cculpepper/ILC2-12_CH32/pcb/VFDSAO.kicad_sch

## KiCad design pcb/VFDSAO.kicad_sch (2024-12-26)

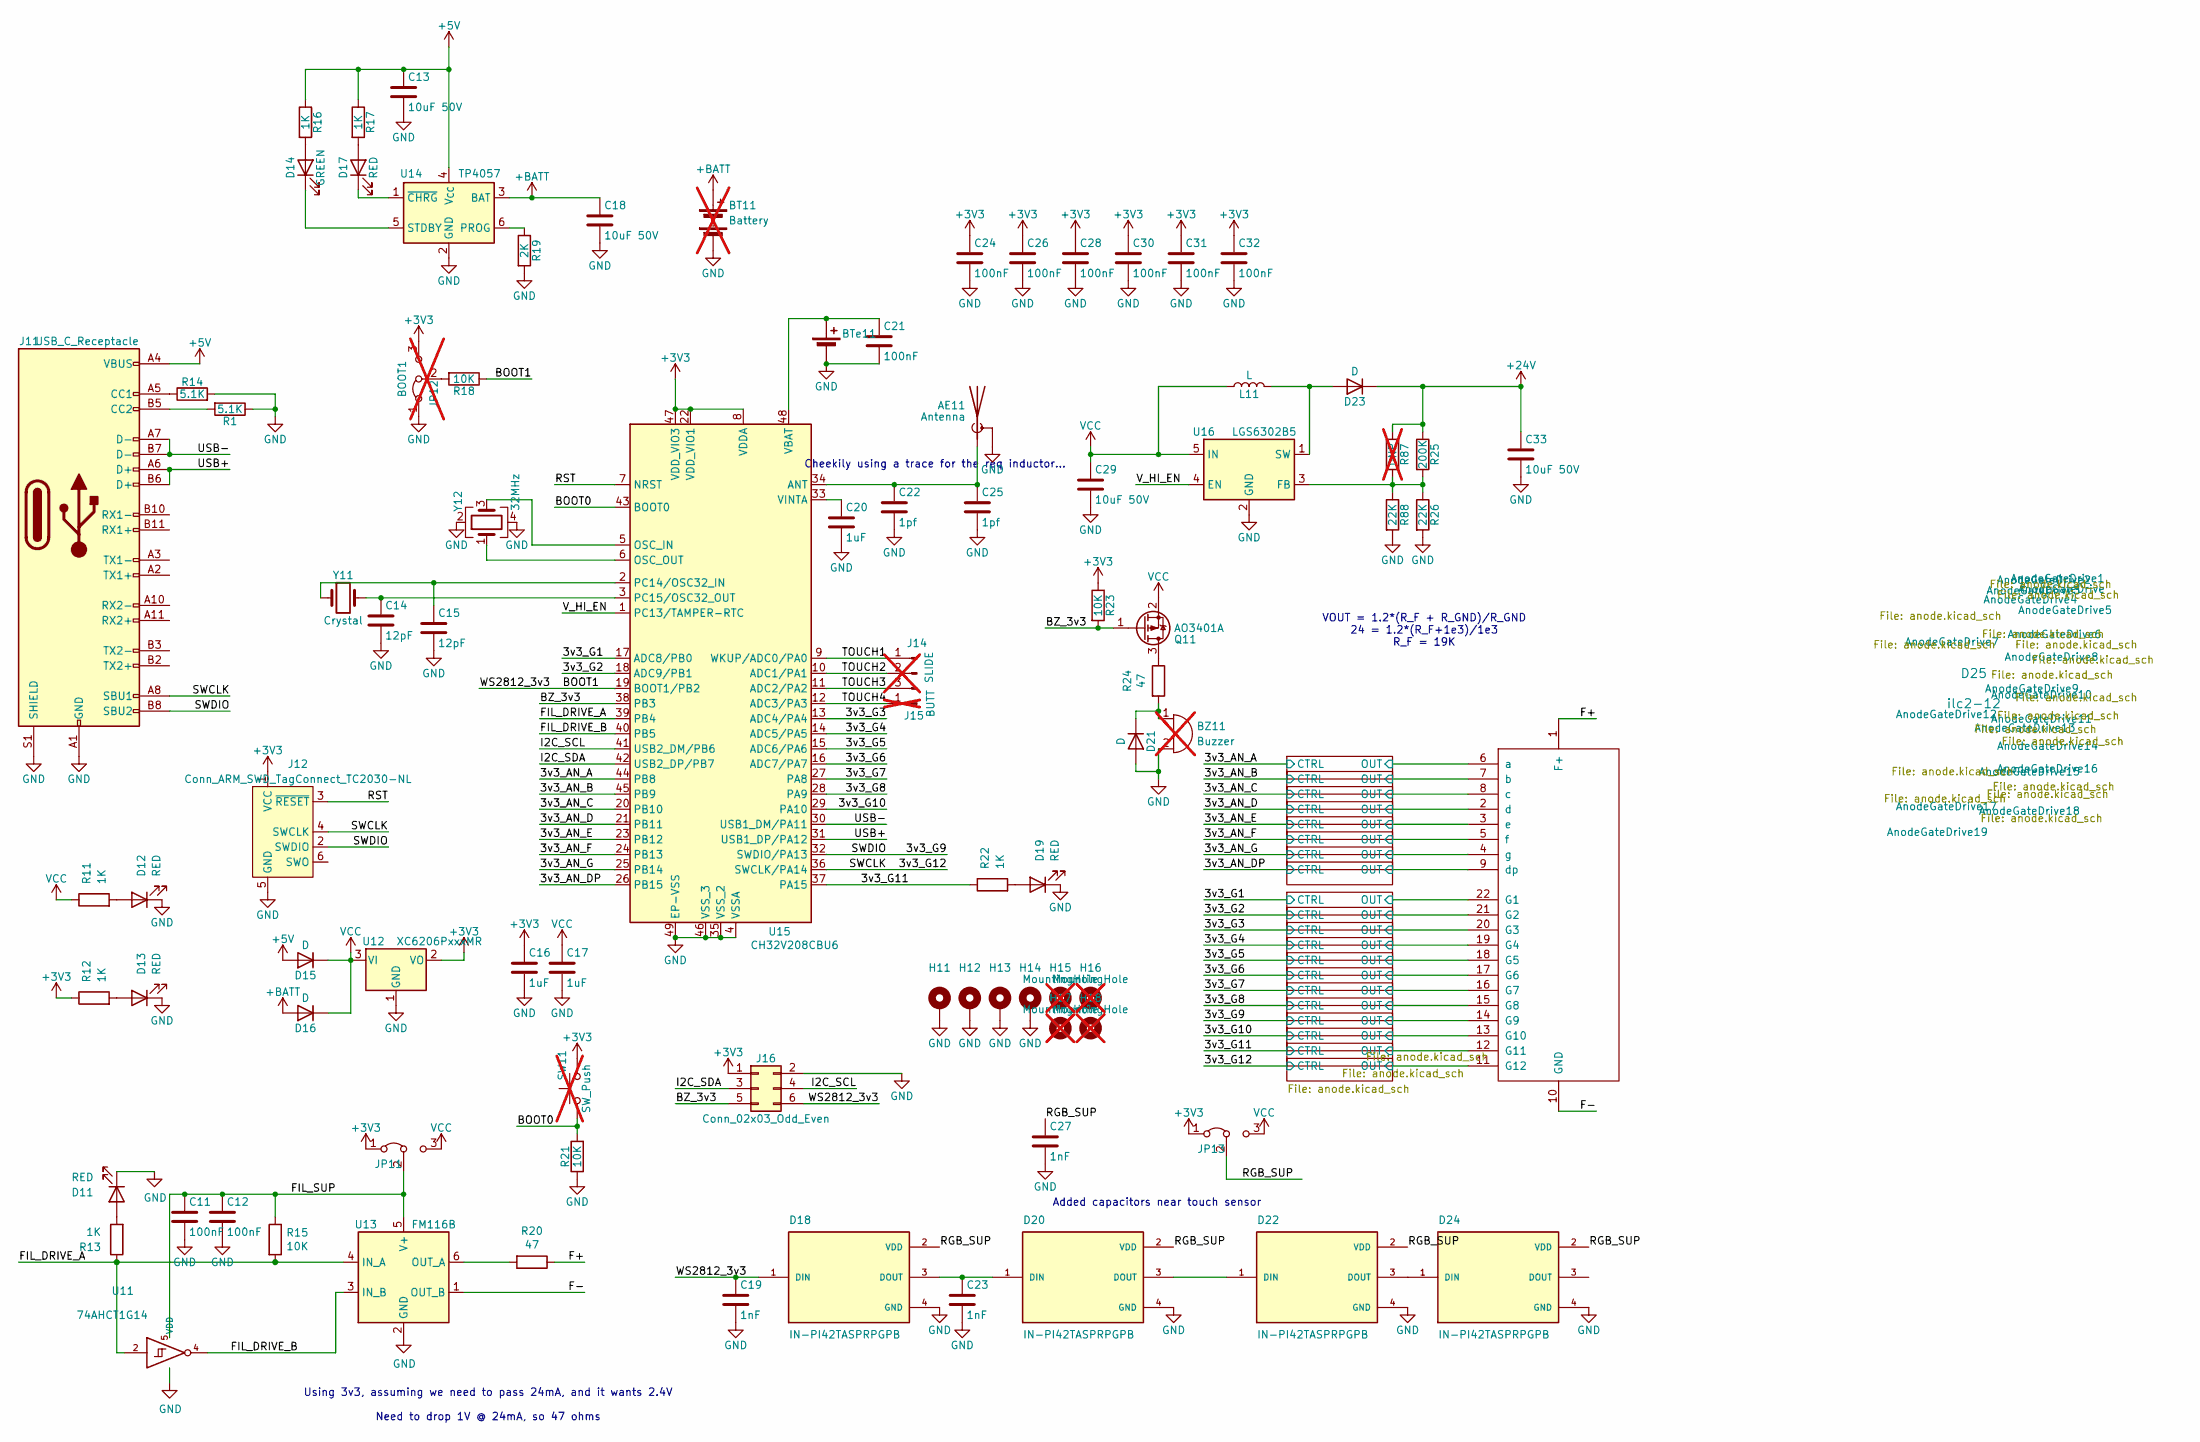
[picture p1: schematic VFDSAO.kicad_sch]

Parts:
AE11: Antenna; Texas_SWRA117Dmodified
BT11: Battery; BatteryHolder_Keystone_1042_1x18650; not fitted
BTe11: BatteryHolder_Multicomp_BC-2001_1x2032
BZ11: Buzzer; 9032; not fitted
C11, C12, C21, C24, C26, C28, C30, C31, C32: 100nF; C_0402_1005Metric; LCSC C307331
C13, C18, C29, C33: 10uF 50V; C_0805_2012Metric; LCSC C440198
C14, C15: 12pF; C_0402_1005Metric; LCSC C1547
C16, C17, C20: 1uF; C_0402_1005Metric; LCSC C52923
C19, C23, C27: 1nF; C_0402_1005Metric; LCSC C1523
C22, C25: 1pf; C_0402_1005Metric; LCSC C1550
D11, D12, D13, D17, D19: RED; LED_0805_2012Metric; LCSC C84256
D14: GREEN; LED_0805_2012Metric; LCSC C2297
D15, D16, D21, D23: D; D_SOD-123; LCSC C8598
D18, D20, D22, D24: IN-PI42TASPRPGPB; LED_IN-PI42TASPRPGPB; PARTREV Oct. 10, 2021; LCSC C524054
D25: ilc2-12
H11, H12, H13, H14: m2.5SMT
H15, H16: MountingHole; MountingHole_2.2mm_M2; not fitted
H17, H18: MountingHole; MountingHole_3.2mm_M3; not fitted
J11: USB_C_Receptacle; USB_C_Receptacle_GCT_USB4105-xx-A_16P_TopMnt_Horizontal; LCSC C393939
J12: Conn_ARM_SWD_TagConnect_TC2030-NL; Tag-Connect_TC2030-IDC-NL_2x03_P1.27mm_Vertical
J14: SLIDE; Slider; not fitted
J15: BUTT; touchButton; not fitted
J16: Conn_02x03_Odd_Even; IDC-Header_2x03_P2.54mm_Vertical
JP11, JP13: Jumper_3_Bridged12; SolderJumper-3_P1.3mm_Bridged12_Pad1.0x1.5mm
JP12: BOOT1; SolderJumper-3_P1.3mm_Bridged12_Pad1.0x1.5mm; not fitted
L11: L; L_APV_ANR252010; LCSC C19267877
Q11: AO3401A; SOT-23; LCSC C15127
R1, R14: 5.1K; R_0402_1005Metric; LCSC C25905
R11, R12, R13, R16, R17, R22: 1K; R_0402_1005Metric; LCSC C11702
R15, R18, R21, R23: 10K; R_0402_1005Metric; LCSC C25744
R19: 2K; R_0402_1005Metric; LCSC C4109
R20, R24: 47; R_0402_1005Metric; LCSC C1096
R25: 200K; R_0402_1005Metric; LCSC C25764
R26, R88: 22K; R_0402_1005Metric; LCSC C25768
R87: DNP; R_0402_1005Metric; not fitted
SW11: SW_Push; SW_Push_1P1T_NO_6x6mm_H9.5mm; not fitted
U11: 74AHCT1G14; SOT-353_SC-70-5; LCSC C460501
U12: XC6206PxxxMR; SOT-23-3; LCSC C5446
U13: FM116B; SOT-23-6; LCSC C2802264
U14: TP4057; TSOT-23-6; LCSC C12044
U15: CH32V208CBU6; QFN-48-1EP_5x5mm_P0.35mm_EP3.7x3.7mm; LCSC C5713556
U16: LGS6302B5; SOT-23-5; LCSC C5123975
Y11: Crystal; Crystal_SMD_3215-2Pin_3.2x1.5mm; LCSC C32346
Y12: 32MHz; Crystal_SMD_3225-4Pin_3.2x2.5mm; LCSC C164054

Connections:
3v3_AN_A: U15.44 (PB8)
3v3_AN_B: U15.45 (PB9)
3v3_AN_C: U15.20 (PB10)
3v3_AN_D: U15.21 (PB11)
3v3_AN_DP: U15.26 (PB15)
3v3_AN_E: U15.23 (PB12)
3v3_AN_F: U15.24 (PB13)
3v3_AN_G: U15.25 (PB14)
3v3_G1: U15.17 (ADC8/PB0)
3v3_G2: U15.18 (ADC9/PB1)
3v3_G3: U15.13 (ADC4/PA4)
3v3_G4: U15.14 (ADC5/PA5)
3v3_G5: U15.15 (ADC6/PA6)
3v3_G6: U15.16 (ADC7/PA7)
3v3_G7: U15.27 (PA8)
3v3_G8: U15.28 (PA9)
3v3_G9: J11.B8 (SBU2), J12.2 (SWDIO), U15.32 (SWDIO/PA13)
3v3_G10: U15.29 (PA10)
3v3_G11: R22.1, U15.37 (PA15)
3v3_G12: J11.A8 (SBU1), J12.4 (SWCLK), U15.36 (SWCLK/PA14)
+3V3: C16.1, C24.1, C26.1, C28.1, C30.1, C31.1, C32.1, J12.1 (VCC), J16.1, JP11.1 (A), JP12.3 (B), JP13.1 (A), R12.1, R23.1, SW11.2, U12.2 (VO), U15.8 (VDDA), U15.22 (VDD_VIO1), U15.47 (VDD_VIO3)
+5V: C13.1, D15.2 (A), J11.A4 (VBUS), J11.A9 (VBUS), J11.B4 (VBUS), J11.B9 (VBUS), R16.1, R17.1, U14.4 (V_{CC})
+24V: C33.1, D23.1 (K), R25.1, R87.1
+BATT: BT11.1 (+), C18.1, D16.2 (A), U14.3 (BAT)
BOOT0: R21.2, SW11.1, U15.43 (BOOT0)
BOOT1: C19.1, D18.1 (DIN), J16.6, R18.1, U15.19 (BOOT1/PB2)
BZ_3v3: J16.5, Q11.1 (G), R23.2, U15.38 (PB3)
F+: D25.1 (F+), R20.1
F-: D25.10 (GND), U13.1 (OUT_B)
FIL_DRIVE_A: R13.1, R15.2, U11.2, U13.4 (IN_A), U15.39 (PB4)
FIL_DRIVE_B: U11.4, U13.3 (IN_B), U15.40 (PB5)
FIL_SUP: C11.1, C12.1, JP11.2 (C), R15.1, U11.5 (VDD), U13.5 (V+)
GND: AE11.2 (Shield), BT11.2 (-), BTe11.2 (-), BZ11.2 (-), C11.2, C12.2, C13.2, C14.2, C15.2, C16.2, C17.2, C18.2, C19.2, C20.2, C21.2, C22.2, C23.2, C24.2, C25.2, C26.2, C27.2, C28.2, C29.2, C30.2, C31.2, C32.2, C33.2, D11.1 (K), D12.1 (K), D13.1 (K), D18.4 (GND), D19.1 (K), D20.4 (GND), D21.2 (A), D22.4 (GND), D24.4 (GND), H11.1, H12.1, H13.1, H14.1, J11.A1 (GND), J11.A12 (GND), J11.B1 (GND), J11.B12 (GND), J11.S1 (SHIELD), J12.5 (GND), J16.2, JP12.1 (A), R1.1, R14.2, R19.2, R21.1, R26.2, R88.2, U11.3 (GND), U12.1 (GND), U13.2 (GND), U14.2 (GND), U15.4 (VSSA), U15.35 (VSS_2), U15.46 (VSS_3), U15.49 (EP-VSS), U16.2 (GND), Y12.2, Y12.4
I2C_SCL: J16.4, U15.41 (USB2_DM/PB6)
I2C_SDA: J16.3, U15.42 (USB2_DP/PB7)
unnamed: AE11.1 (A), C22.1, C25.1, U15.34 (ANT)
unnamed: BTe11.1 (+), C21.1, U15.48 (VBAT)
unnamed: BZ11.1 (+), D21.1 (K), R24.2
unnamed: C14.1, U15.3 (PC15/OSC32_OUT), Y11.2
unnamed: C15.1, U15.2 (PC14/OSC32_IN), Y11.1
unnamed: C20.1, U15.33 (VINTA)
unnamed: C23.1, D18.3 (DOUT), D20.1 (DIN)
unnamed: D11.2 (A), R13.2
unnamed: D12.2 (A), R11.2
unnamed: D13.2 (A), R12.2
unnamed: D14.1 (K), U14.5 (STDBY)
unnamed: D14.2 (A), R16.2
unnamed: D17.1 (K), U14.1 (~CHRG)
unnamed: D17.2 (A), R17.2
unnamed: D19.2 (A), R22.2
unnamed: D20.3 (DOUT), D22.1 (DIN)
unnamed: D22.3 (DOUT), D24.1 (DIN)
unnamed: D23.2 (A), L11.2, U16.1 (SW)
unnamed: J11.A5 (CC1), R14.1
unnamed: J11.B5 (CC2), R1.2
unnamed: JP12.2 (C), R18.2
unnamed: Q11.3 (D), R24.1
unnamed: R19.1, U14.6 (PROG)
unnamed: R20.2, U13.6 (OUT_A)
unnamed: R25.2, R26.1, R87.2, R88.1, U16.3 (FB)
unnamed: U15.5 (OSC_IN), Y12.3
unnamed: U15.6 (OSC_OUT), Y12.1
OUT: D25.2 (d), D25.3 (e), D25.4 (g), D25.5 (f), D25.6 (a), D25.7 (b), D25.8 (c), D25.9 (dp), D25.11 (G12), D25.12 (G11), D25.13 (G10), D25.14 (G9), D25.15 (G8), D25.16 (G7), D25.17 (G6), D25.18 (G5), D25.19 (G4), D25.20 (G3), D25.21 (G2), D25.22 (G1)
RGB_SUP: C27.1, D18.2 (VDD), D20.2 (VDD), D22.2 (VDD), D24.2 (VDD), JP13.2 (C)
RST: J12.3 (~RESET), U15.7 (NRST)
TOUCH1: J14.1, U15.9 (WKUP/ADC0/PA0)
TOUCH2: J14.2, U15.10 (ADC1/PA1)
TOUCH3: J14.3, U15.11 (ADC2/PA2)
TOUCH4: J15.1, U15.12 (ADC3/PA3)
USB+: J11.A6 (D+), J11.B6 (D+), U15.31 (USB1_DP/PA12)
USB-: J11.A7 (D-), J11.B7 (D-), U15.30 (USB1_DM/PA11)
VCC: C17.1, C29.1, D15.1 (K), D16.1 (K), JP11.3 (B), JP13.3 (B), L11.1, Q11.2 (S), R11.1, U12.3 (VI), U16.5 (IN)
V_HI_EN: U15.1 (PC13/TAMPER-RTC), U16.4 (EN)

Notes on the sheet:
Added capacitors near touch sensor
VOUT = 1.2*(R_F + R_GND)/R_GND 24 = 1.2*(R_F+1e3)/1e3 R_F = 19K
Using 3v3, assuming we need to pass 24mA, and it wants 2.4V Need to drop 1V @ 24mA, so 47 ohms
Cheekily using a trace for the req inductor...
