cculpepper/ILC2-12_CH32/pcb/anode.kicad_sch

## KiCad design pcb/anode.kicad_sch (2024-12-26)

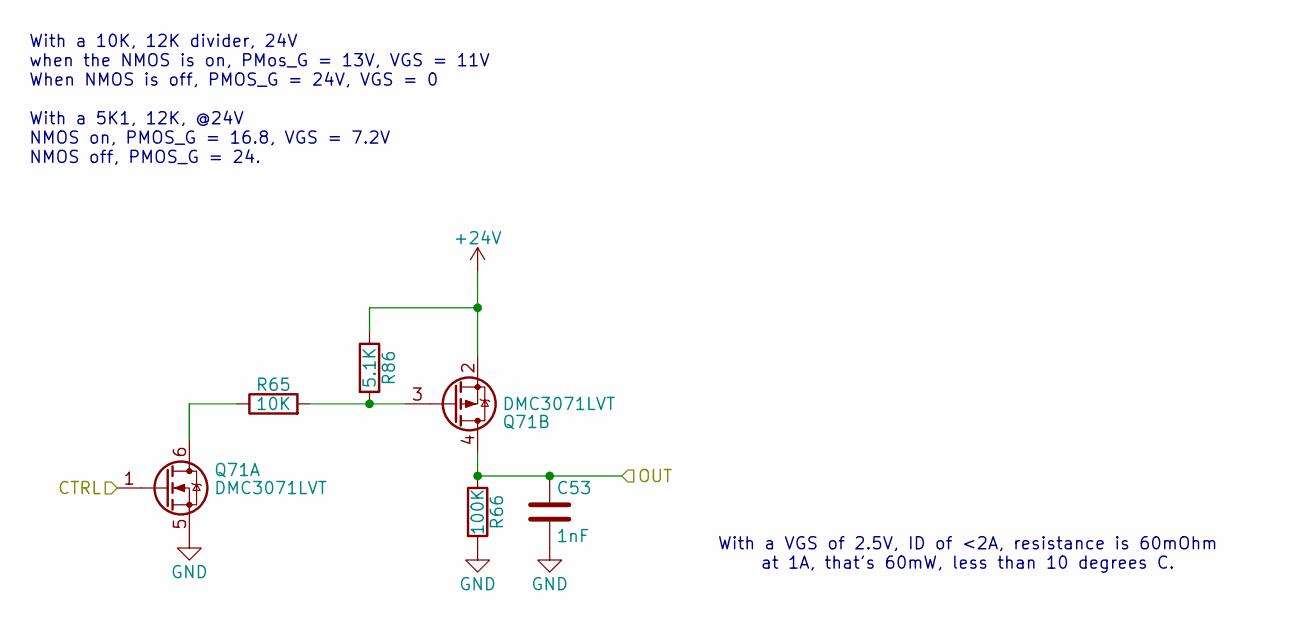
[picture p2: schematic anode.kicad_sch]

Parts:
C53: 1nF; C_0402_1005Metric; LCSC C1523
Q71: DMC3071LVT; SOT-23-6; LCSC C18221386
R65: 10K; R_0402_1005Metric; LCSC C25744
R66: 100K; R_0402_1005Metric; LCSC C25741
R86: 5.1K; R_0402_1005Metric; LCSC C25905

Connections:
+24V: Q71.2 (S), R86.1
CTRL: Q71.1 (G)
GND: C53.2, Q71.5 (S), R66.2
unnamed: Q71.3 (G), R65.2, R86.2
unnamed: Q71.6 (D), R65.1
OUT: C53.1, Q71.4 (D), R66.1

Notes on the sheet:
With a VGS of 2.5V, ID of <2A, resistance is 60mOhm at 1A, that's 60mW, less than 10 degrees C.
With a 10K, 12K divider, 24V when the NMOS is on, PMos_G = 13V, VGS = 11V When NMOS is off, PMOS_G = 24V, VGS = 0 With a 5K1, 12K, @24V NMOS on, PMOS_G = 16.8, VGS = 7.2V NMOS off, PMOS_G = 24.
