cculpepper/ILC2-12_CH32/(commit log)

2024-12-11 Moved files
    [VFDSAO.kicad_sch, anode.kicad_sch]
2024-12-26 RTM, pushing to germany
    [VFDSAO-B_Cu.gbr, VFDSAO-B_Mask.gbr, VFDSAO-B_Paste.gbr, VFDSAO-B_Silkscreen.gbr, VFDSAO-Edge_Cuts.gbr, VFDSAO-F_Cu.gbr, VFDSAO-F_Mask.gbr, VFDSAO-F_Paste.gbr]
2025-01-09 Changed to my own copy of the VFD footprint
