cculpepper/ILC2-12_CH32/(notices)

Notices in the files:
pcb/PCB-USB-C/README.md:
License: CC BY 4.0
